x893/CMSIS-DAP/README.md

CMSIS-DAP Version 0.01
----------------------

See Readme.htm for details
