x893/CMSIS-DAP/html/CMSIS_DAP_INTERFACE.png

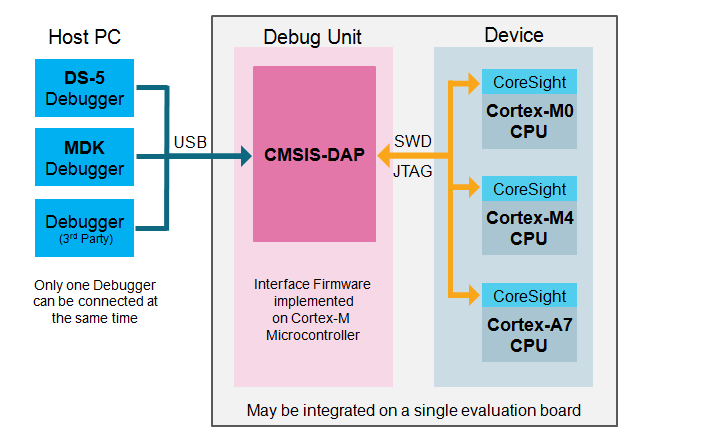
html/CMSIS_DAP_INTERFACE.png
