x893/CMSIS-DAP/html/MDK_Device.png

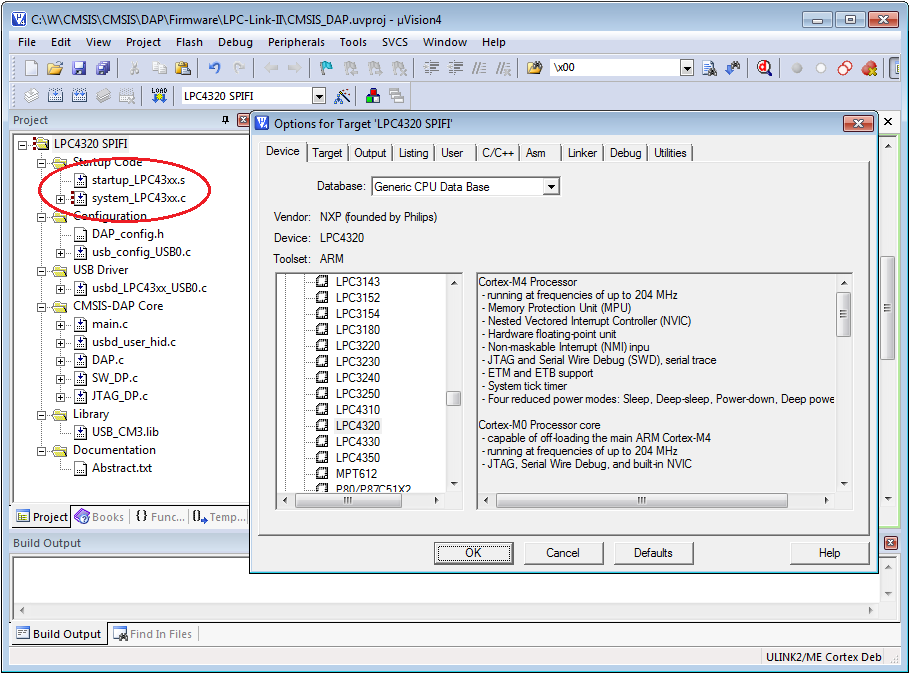
html/MDK_Device.png
