x893/CMSIS-DAP/html/MDK_USB.png

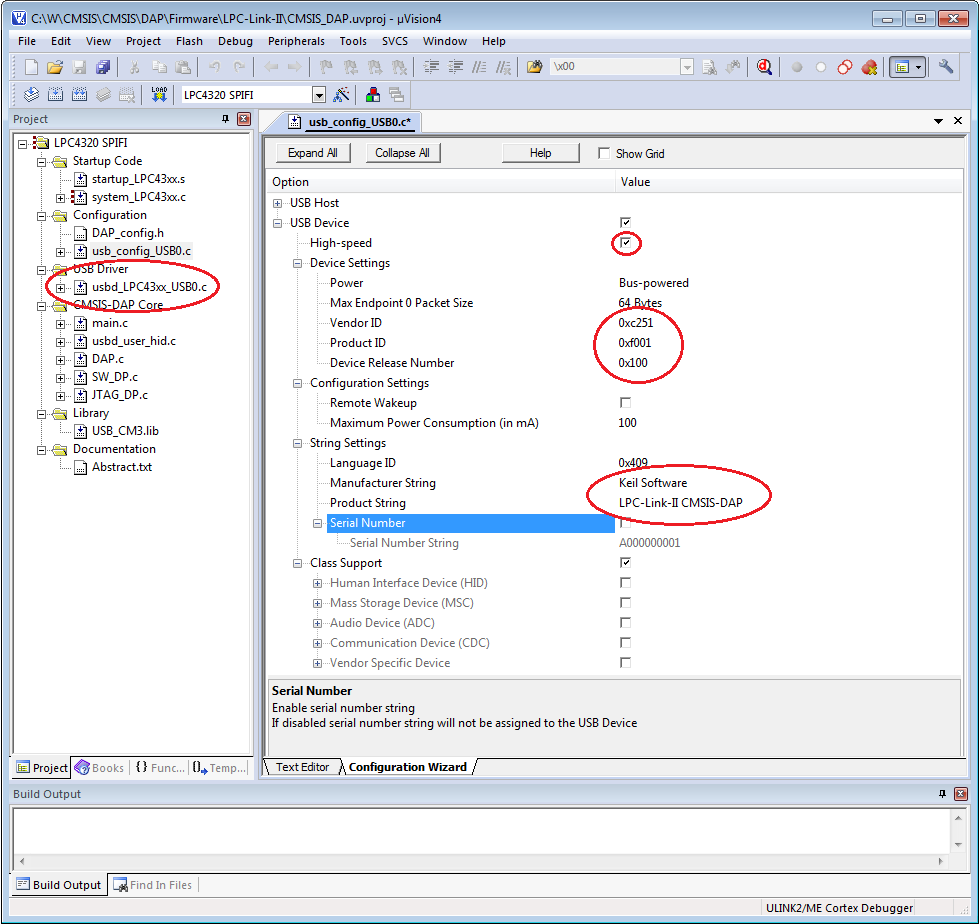
html/MDK_USB.png
