x893/CMSIS-DAP/HW_STM32/CMSIS-DAP-Other/10pin.png

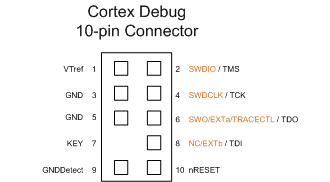
HW_STM32/CMSIS-DAP-Other/10pin.png
