x893/CMSIS-DAP/HW_STM32/CMSIS-DAP-Other/STM32-P103-sch.gif

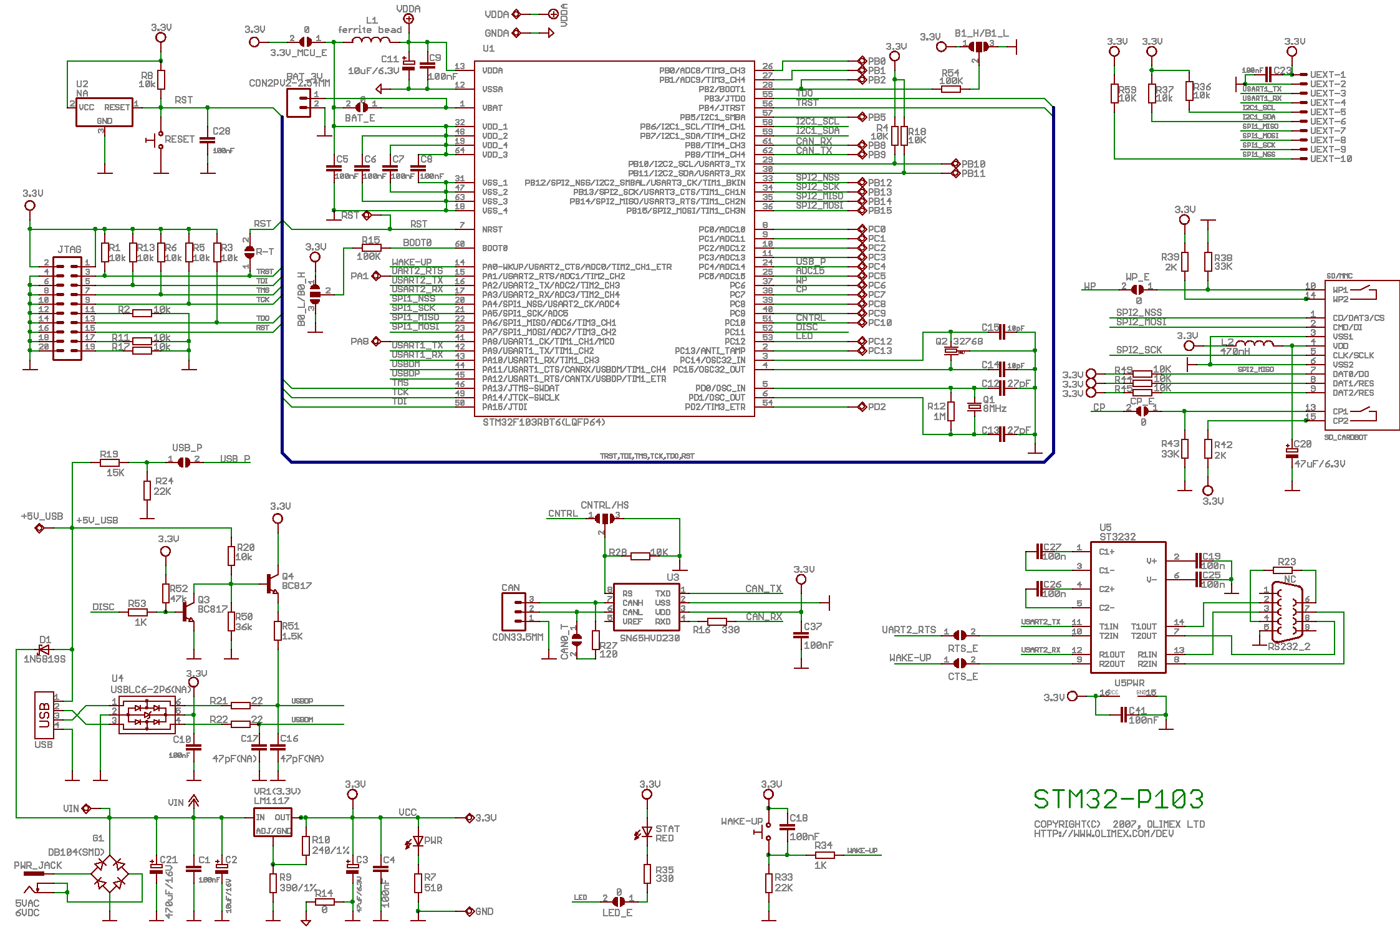
HW_STM32/CMSIS-DAP-Other/STM32-P103-sch.gif
