x893/CMSIS-DAP/HW_STM32/JLink-OB-F072.png

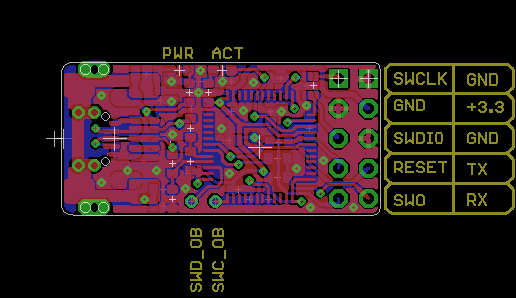
HW_STM32/JLink-OB-F072.png
