x893/CMSIS-DAP/HW_STM32/CMSIS-DAP-Other/CMSIS_DAP.ods

 | CMSIS_DAP.sch
RefDes | Value | Count
--------------- | --------------- | ------
C13 | SMD-0805-X7R-0.01uF-50V | 1
C2 | SMD-0805-X7R-0.1uF-50V | 7
C3
C5
C6
C7
C8
C14
C9 | SMD-0805-NP0-12pF | 2
C10
C11 | SMD-0805-NP0-18pF | 2
C12
C1 | SMD3216-10uF-16V-A | 2
C4
DD1 | STM32F103C8T6 | 1
DA1 | LP2985AIM5-3.0 (LP2981-3.0) | 1
R5 | SMD-0603-1k | 2
R13
R24 | SMD-0603-1M | 1
R1 | SMD-0603-1.5k | 1
R14 | SMD-0603-2.2k | 1
R11 | SMD-0603-2.2M | 1
R9 | SMD-0603-3.3 | 1
R2 | SMD-0603-10k | 5
R15
R16
R19
R23
R22 | SMD-0603-22 | 1
R7 | SMD-0603-22k | 2
R20
R3 | SMD-0603-36k | 1
R4 | SMD-0603-47k | 1
R17 | SMD-0805-1k | 2
R18
R12 | SMD-0805-10 | 1
R6 | SMD-0805-5k | 1
R21 | SMD-0805-22 | 1
R8 | SMD-1206-22 | 2
R10
VD2 | FYLS-0805 (GREEN) | 1
VD1 | FYLS-0805 (RED) | 1
VT1 | BC817 | 2
VT2
XP5 | BH-10 | 1
XP2 | PLS-2 | 3
XP3
XP4
XP1 | PLS-4 | 2
XP6
XS1 | USB_B | 1
ZQ1 | KX38T-32768Hz | 1
ZQ2 | HC49/u-8.000MHz | 1
