x893/CMSIS-DAP/(threads)

Thread 4 (2015-05-25):

Can't install HID driver for F103 v2

steevenlee, 2015-05-25:
I'm using MDK5 + CMSIS_DAP_USB project, set reconfiguration to V2, both HID and CDC are enabled, from test, only CDC are properly installed on Windows7 32 bit version. HID can't be recognized.

If I disable CDC in usb_config.c, HID can be auto recognized w/o installing any driver.

Finally I got it worked by changing VID/PID to official one and install driver from mbed, it will identify HID driver, then, install inf for CDC ACM.

x893, 2015-05-28:
For HID no need any driver under Windows 7. I use 64 bit version and never have problem.

steevenlee, 2015-05-29:
Try it on a new desktop :)

Closed 2015-05-28.

Thread 5 (2015-05-28):

How about merge back this project back to master?

steevenlee, 2015-05-28:
I love your work, STM32 is popular... is there license issue if I give this a try?

x893, 2015-05-28:
CMSIS-DAP codes initially provide by ARM

steevenlee, 2015-06-01:
I found a big issue to merge SMT32 support to official branch: stm32f10x only support 8 endpoints, for a complete feature support, need 3+2+2 for CDC+MSC+HID, plus endpoint 0, is it possible to support them all?

x893, 2015-06-01:
i never use this combination only HID + CDC but you can try

Closed 2015-05-28.

Thread 6 (2015-09-07):

Can't find MSD on my computer.

overheat, 2015-09-07:
I have flashed the hex file to my st-link. And my computer recognized CDC(uart) and debugger.
But there is no MSD showing like other mbed board.

Please help me. Thanks!

x893, 2015-09-07:
MSD not supported

Closed 2015-09-07.

Thread 8 (2016-01-14):

ST-LinkV2 nRESET pin

siorpaes, 2016-01-14:
Hello,

I tried CMSIS-DAP on ST-LinkV2 dongle using Keil but found some issues with nRESET signal: the target could not reset nor I could use the "attach under reset" debugger option. The logic analyzer could not see any activity on this signal either.
I checked where the nRESET pin is connected on this board and sorted out that it is hooked to PB6 (Pin 42), and not PB0 as reported in the code.

I changed to correct pin and now it's working like a charm. Is the dongle I have yet a different hardware version ? Or is there actually a minor bug in the code ?

Thanks for your attention

Regards,

David S.

x893, 2016-01-14:
Hello,
I have various version of dongle - so may be make a mistake.
I'll review and fix

siorpaes, 2016-01-14:
All right, thanks! let me know if you need any further information, esp on the dongle's hardware

x893, 2016-01-16:
I check ST-Link V2 schematic (from NUCLEO board) and see PB0 for T_NRST signal. PB6 used for SWM_RST (for SWIM protocol)

siorpaes, 2016-01-17:
Yes, you are correct: the schematic of Nucleo and Discovery boards do have NRST routed to PB0. However, the RST signal of the ST-LinkV2 dongle I have is connected to PB6. I triple checked continuity with multimeter. Could you verify on yours ?

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

x893, 2016-01-17:
I havn't V2 version but you can make new configuration STLINKV2 and make changes for nRST. Later send pull request. I can do this myself but later. :)

Closed 2016-01-14.

Thread 10 (2016-10-04):

Did not find most variables declared in RDDI example

umesh4b4, 2016-10-04:
Hi,

I did not find most number of variables declared in RDDI example RDDI_DAP_IF.cpp file  given in CMSIS-DAP-> RDDI->Example. However I have solved with few variables and macros. I could not find below variables, macros and data types.

1. MonConf.Opt
2. PORT_SW
3. RWPage
4. TRNMODE
5. TRNVERIFY
6. DBG_Addr
7. RgARMCM
8. RgARMFPU

Regards

Umesh

x893, 2016-10-04:
Ask about on ARM forum. RDDI... not changed from original ARM files.

Closed 2016-10-04.

Thread 11 (2017-08-16):

USB devices are not recognized

HareGun, 2017-08-16:
I want to make a CMSIS DAP using CMSIS 5.1.0. I built a new project in line with KEIL's official website. Part of the DAP was added, but he didn't work. Can you help me with this problem? Thanks very much.

http://www.keil.com/pack/doc/CMSIS/DAP/html/group__DAP__ConfigUSB__gr.html

bowman85, 2017-08-17:
I can recomended to use this lib.  https://stm32f4-discovery.net/2014/05/all-stm32f429-libraries-at-one-place/

HareGun, 2017-08-17:
Thanks.But I'm using STM32F1. I've also tried to configure only the USB and RTX sections without DAP (adding the USB connection function to the main function). My computer is still hard to recognize. The D+ pin has a pull-up resistor.

Closed 2018-01-11.

Thread 12 (2018-01-11):

When compiled HID device is not recognised by the system.

diymat, 2018-01-11:
Hi. Just a quick question-maybe you know. When I flash the stm32F103 with the .hex file provided - everything is ok, when I compile it myself only CDC device is recognised. Do you have any clues?

x893, 2018-01-11:
You're change any settings (optimization or other) ?
Can you check with debugger ?

diymat, 2018-01-11:
No, I have just cloned it and opened in the free version of Keil (I do not use Keil). I can debug of course

x893, 2018-01-11:
Project from github use F102 processor settings. May be need switch to correct version V1..V3 and F103 processor. Please check project settings for your board.

diymat, 2018-01-11:
I have changed the uC of course.  But where is the version?

diymat, 2018-01-11:
Recompiled - checked all the uC settings and the effect is the same -  VCOM is detected, HID is not. When I flash the provided HEX file it detects both :)

x893, 2018-01-11:
What's hex you flash ?

CMSIS-DAP-V1-F103.hex
CMSIS-DAP-V2-F103.hex
CMSIS-DAP-V3-F103.hex

diymat, 2018-01-11:
just flashed all of them. All provide both devices. The compiled version is not and to be stranger it detects as a different COM port which indicates some differences between descriptors sent.

x893, 2018-01-11:
Select configuration in tollbar combo box (near Download toolbar button).
Also check pins in DAP_Config.h for your board.

diymat, 2018-01-11:
As I wrote I do not know Keil :) and I did not noticed this toolbar. But unfortunately free version does not allow me to link the MDK

diymat, 2018-01-11:
Thank you very much for your support.

x893, 2018-01-11:
Can you check DAP_Config.h for your board ?
You can open it in vim/nano/notepad and define configuration.
Also you can flash hex files and see correct hex for your board (USB and SWD/SWC/JTAG pins configuration) or add schematic of your board here and i see in depth.

diymat, 2018-01-11:
Hi. Thank you very much. Actually I  have everything I need.  I develop a board with DAP - so I just wanted to go through the existing implementation to do not reinvent the wheel. It is a STM32F3 board with many other interfaces on it. I honestly appreciate your help.

x893, 2018-01-11:
No problem.

Closed 2018-01-11.

Thread 14 (2018-04-07):

"CMSIS-DAP CDC" driver installation problem

alsaleem00, 2018-04-07:
I am developing a code for RTL8710 Wifi module, cortex-M3. The toolchain/sdk requires OpenOCD/CMSIS-DAP to program the module.
I have a STM32F103C8T6 board that I would like to make as CMSIS-DAP. I tried all firmware images in the firmware/stm32/hex, but still there is error when trying to update driver on windows 8.1

> The drivers for this device are not installed. (Code 28)
> There are no compatible drivers for this device.

I already configured windows to "ignore" driver signing and restarted several times.
I point update driver update to folder that contains the "CMSIS_DAP.inf" file.

OpenOCD returns the following error

> Error: CMSIS-DAP command CMD_INFO failed

Did I miss a step to install driver?

Thanks.

Thread 15 (2018-09-20):

STM32 Blue Pill - using V1.hex

kissste, 2018-09-20:
Hello,

I have uploaded V1.hex to SMT32 Blue Pill board (patched R10 resistor to get USB going).

I see CDC and HID devices but on Linux (Ubuntu 18.04) but there is not mass-storage device (mbedls is looking for it). I'm trying to get this working with mbed (to start with mbedls).

The target is connected via PA2 and PA4 as noted in build/ code of BOARD_V1.
I have not solder/ checked the LEDs yet. And, think I will hook up a scope to see what is being sent on SWCLK and SWDIO wires.

Any suggestions for what could be the issue, how to debug?

Thank you very much
