x893/CMSIS-DAP/HW_STM32/CMSIS-DAP-X893/STLink.v21.pdf

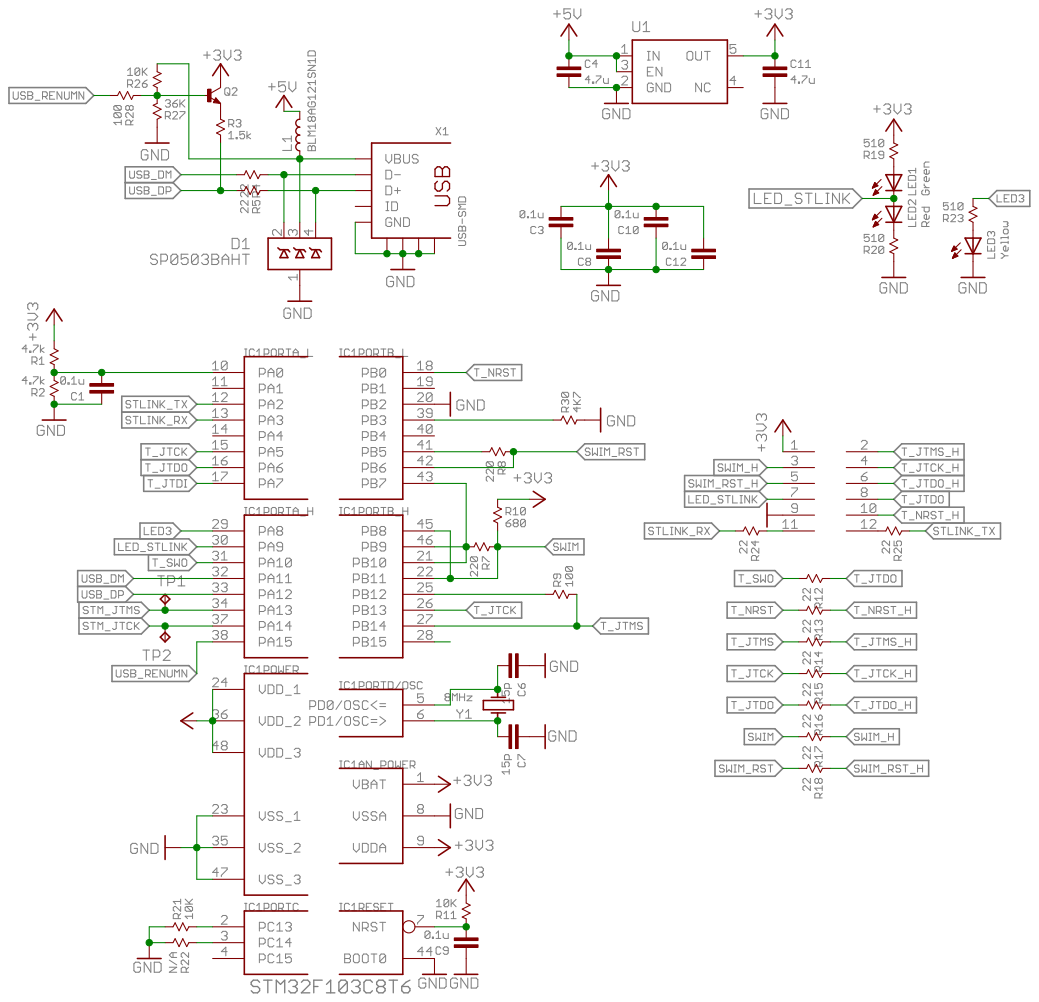
[picture p7: page 1]
