x893/CMSIS-DAP/HW_STM32/CMSIS-DAP-X893/CMSIS-DAP.V2.pdf

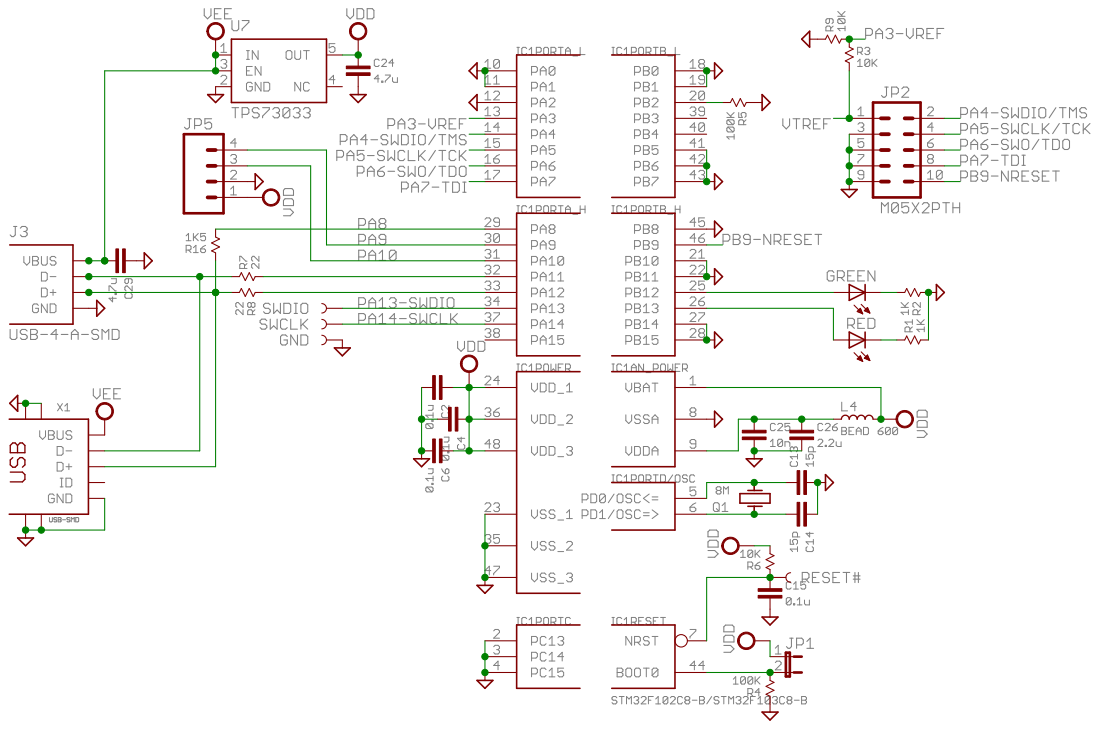
[picture p8: page 1]
