x893/CMSIS-DAP/HW_STM32/CMSIS-DAP-X893/CMSIS-DAP.V1.pdf

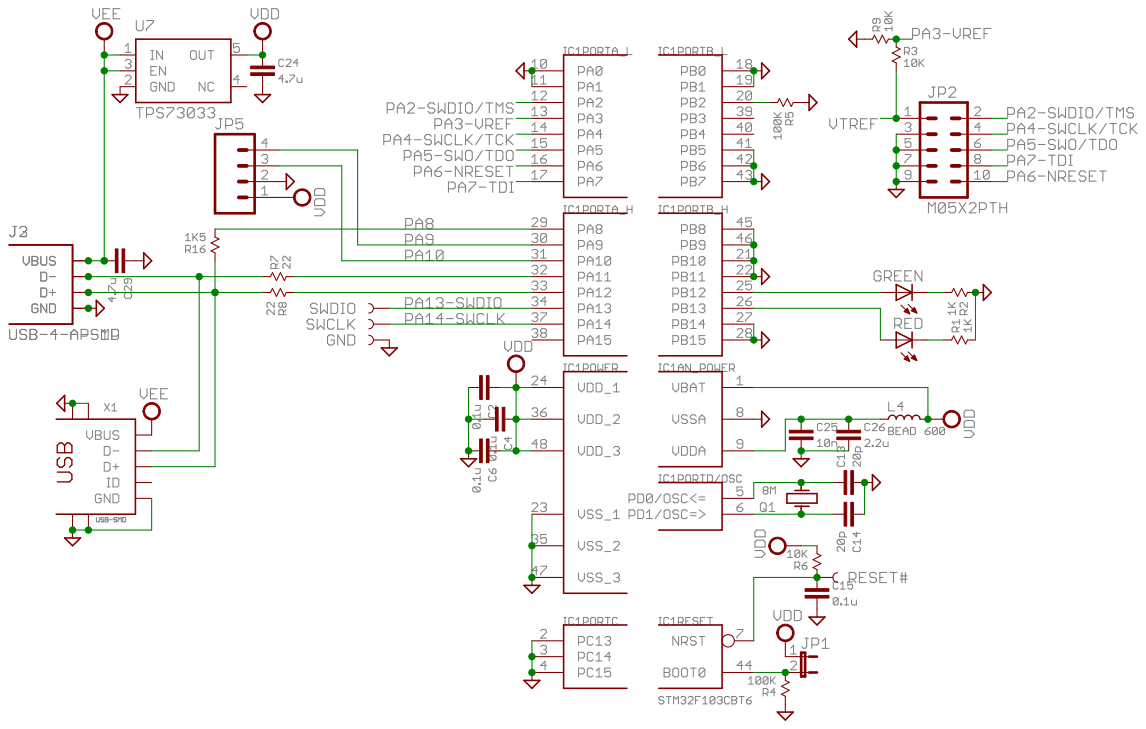
[picture p9: page 1]
