x893/CMSIS-DAP/(list of files, drawings)

Other design files:
HW_STM32/CMSIS-DAP-Other/CMSIS_DAP.pcb
