x893/CMSIS-DAP/HW_STM32/JLink-OB-F072.brd

## EAGLE design HW_STM32/JLink-OB-F072.brd (2016-11-28)

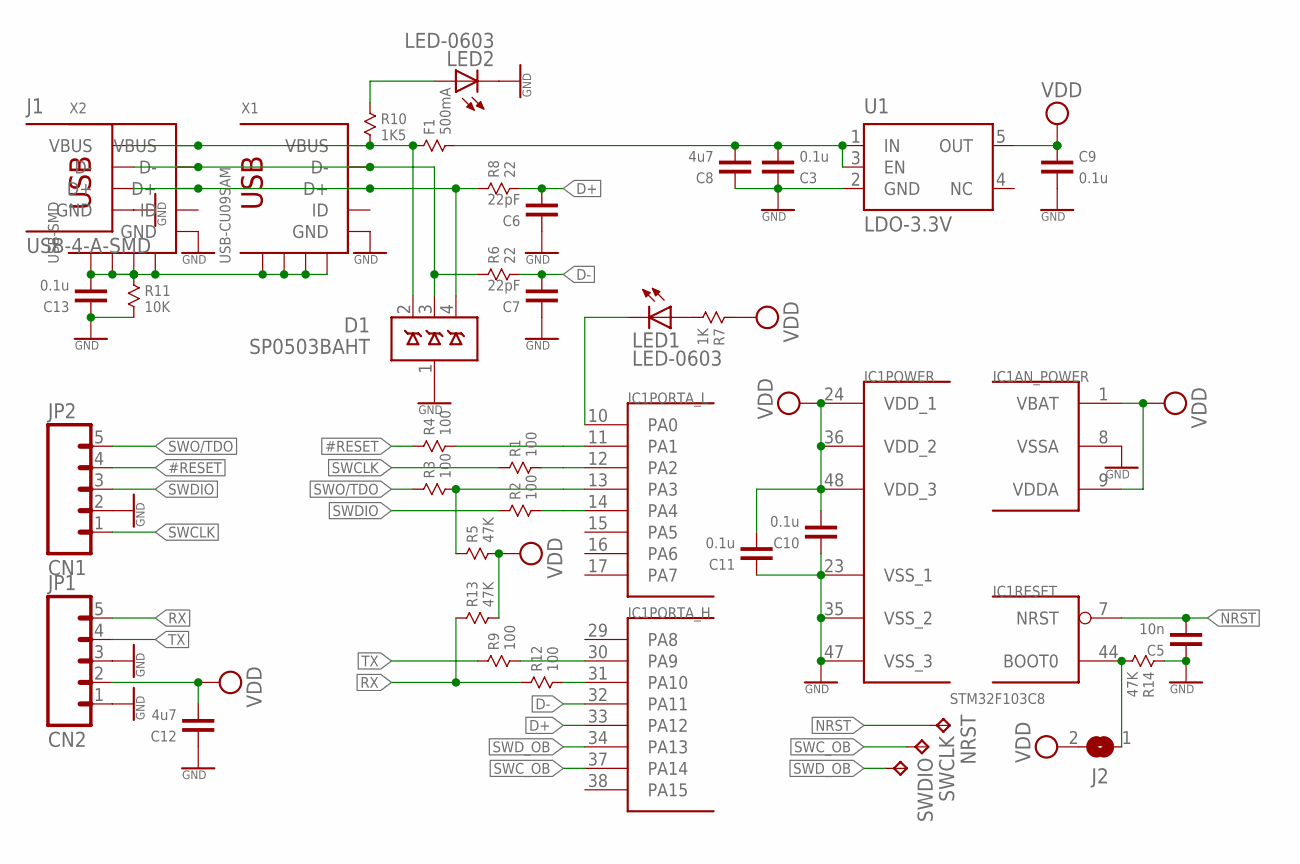
[picture p10: schematic JLink-OB-F072.sch]

Parts:
C3, C9, C10, C11, C13: 0.1u; 0603
C5: 10n; 0603
C6, C7: 22pF; 0603
C8, C12: 4u7; 0603
D1: SP0503BAHT; SOT143
F1: 500mA; 0805
IC1: STM32F103C8; TQFP48
J1: USB-4-A-SMD; USB-A-SMD
J2: JUMPER2-0402-NC; JUMPER2-0402_NC
JP1: CN2; 1X05
JP2: CN1; 1X05
LED1, LED2: LED-0603; CHIPLED_0603
NRST: TPTP10R; TP10R
R1, R2, R3, R4, R9, R12: 100; 0603
R5, R13, R14: 47K; 0603
R6, R8: 22; 0603
R7: 1K; 0603
R10: 1K5; 0603
R11: 10K; 0603
SWCLK: TPTP10R; TP10R
SWDIO: TPTP10R; TP10R
U1: LDO-3.3V; SOT23-5
X1: USB-CU09SAM; CU09SAM
X2: USB-SMD; USB-MINIB

Connections:
#RESET: JP2.4, R4.1
#RESETR: IC1.11 (PA1), R4.2
D+: C6.1, IC1.33 (PA12), R8.2
D-: C7.1, IC1.32 (PA11), R6.2
GND: C3.2, C5.2, C6.2, C7.2, C8.2, C9.1, C10.2, C11.2, C12.2, C13.2, D1.1 (GND), IC1.8 (VSSA), IC1.23 (VSS_1), IC1.35 (VSS_2), IC1.47 (VSS_3), J1.GND, JP1.1, JP1.3, JP2.2, LED2.C, R11.2, R14.1, U1.2 (GND), X1.5 (GND), X2.GND
unnamed: LED1.A, R7.2
unnamed: D1.4 (D3), J1.D+, R8.1, X1.3 (D+), X2.D+
unnamed: IC1.10 (PA0), LED1.C
unnamed: D1.3 (D2), J1.D-, R6.1, X1.2 (D-), X2.D-
unnamed: IC1.30 (PA9), R9.2
unnamed: IC1.31 (PA10), R12.2
unnamed: LED2.A, R10.1
unnamed: C3.1, C8.1, F1.2, U1.1 (IN), U1.3 (EN)
unnamed: IC1.44 (BOOT0), J2.1, R14.2
unnamed: C13.1, R11.1, X1.GND@1 (GND), X1.GND@2 (GND), X1.GND@3 (GND), X1.GND@4 (GND), X2.GND@1 (GND), X2.GND@2 (GND), X2.GND@3 (GND), X2.GND@4 (GND)
NRST: C5.1, IC1.7 (NRST), NRST.TP
RX: JP1.5, R12.1, R13.1
SWCLK: JP2.1, R1.1
SWCLKR: IC1.12 (PA2), R1.2
SWC_OB: IC1.37 (PA14), SWCLK.TP
SWDIO: JP2.3, R2.1
SWDIOR: IC1.14 (PA4), R2.2
SWD_OB: IC1.34 (PA13), SWDIO.TP
SWO/TDO: JP2.5, R3.1
SWOR: IC1.13 (PA3), R3.2, R5.1
TX: JP1.4, R9.1
VBUS: D1.2 (D1), F1.1, J1.VUSB (VBUS), R10.2, X1.1 (VBUS), X2.VBUS
VDD: C9.2, C10.1, C11.1, C12.1, IC1.1 (VBAT), IC1.9 (VDDA), IC1.24 (VDD_1), IC1.36 (VDD_2), IC1.48 (VDD_3), J2.2, JP1.2, R5.2, R7.1, R13.2, U1.5 (OUT)

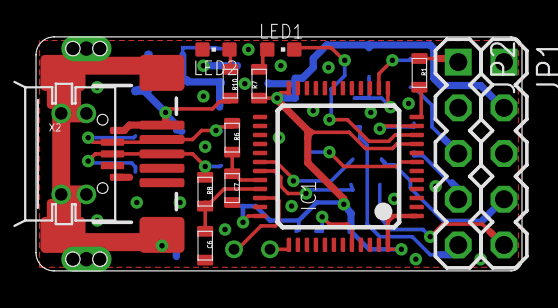
[picture p11: board JLink-OB-F072.brd from above]

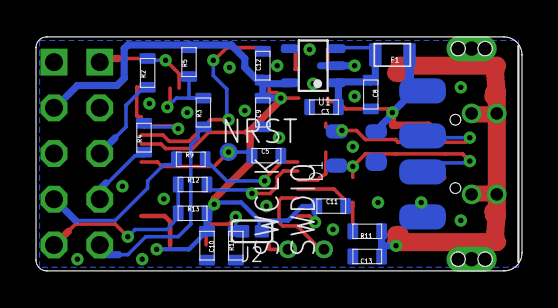
[picture p12: board JLink-OB-F072.brd from below]

Board: 2 copper layers, 27.0 x 13.0 mm, 39 parts (25 on the bottom side), 28 nets.
