x893/CMSIS-DAP/HW_STM32/JLink-OB.brd

## EAGLE design HW_STM32/JLink-OB.brd (2016-01-17)

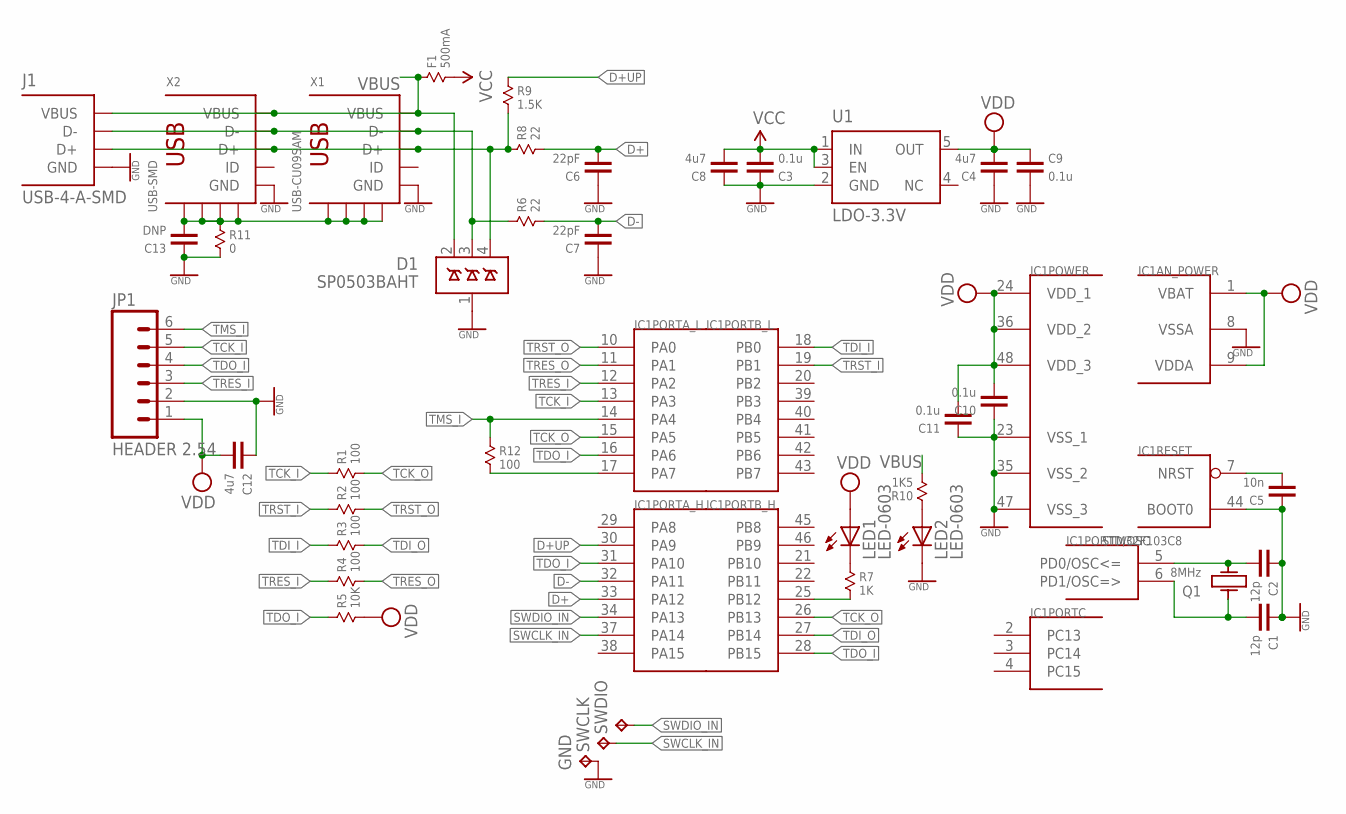
[picture p13: schematic JLink-OB.sch]

Parts:
C1, C2: 12p; 0603
C3, C9, C10, C11: 0.1u; 0603
C4, C8, C12: 4u7; 0603
C5: 10n; 0603
C6, C7: 22pF; 0603
C13: DNP; 0603
D1: SP0503BAHT; SOT143
F1: 500mA; 0805
GND: TPTP12R; TP12R
IC1: STM32F103C8; TQFP48
J1: USB-4-A-SMD; USB-A-SMD
JP1: HEADER 2.54; 1X06
LED1, LED2: LED-0603; CHIPLED_0603
Q1: 8MHz; KX-9A
R1, R2, R3, R4, R12: 100; 0603
R5: 10K; 0603
R6, R8: 22; 0603
R7: 1K; 0603
R9: 1.5K; 0603
R10: 1K5; 0603
R11: 0; 0603
SWCLK: TPTP12R; TP12R
SWDIO: TPTP12R; TP12R
U1: LDO-3.3V; SOT23-5
X1: USB-CU09SAM; CU09SAM
X2: USB-SMD; USB-MINIB

Connections:
D+: C6.1, IC1.33 (PA12), R8.2
D+UP: IC1.30 (PA9), R9.1
D-: C7.1, IC1.32 (PA11), R6.2
GND: C1.2, C2.2, C3.2, C4.2, C5.2, C6.2, C7.2, C8.2, C9.1, C10.2, C11.2, C12.2, C13.2, D1.1 (GND), GND.TP, IC1.8 (VSSA), IC1.23 (VSS_1), IC1.35 (VSS_2), IC1.44 (BOOT0), IC1.47 (VSS_3), J1.GND, JP1.2, LED2.C, R11.2, U1.2 (GND), X1.5 (GND), X2.GND
unnamed: C5.1, IC1.7 (NRST)
unnamed: D1.4 (D3), J1.D+, R8.1, R9.2, X1.3 (D+), X2.D+
unnamed: IC1.25 (PB12), R7.2
unnamed: D1.3 (D2), J1.D-, R6.1, X1.2 (D-), X2.D-
unnamed: C2.1, IC1.5 (PD0/OSC<=), Q1.3 (2)
unnamed: C1.1, IC1.6 (PD1/OSC=>), Q1.1
unnamed: LED2.A, R10.1
unnamed: LED1.C, R7.1
unnamed: C13.1, R11.1, X1.GND@1 (GND), X1.GND@2 (GND), X1.GND@3 (GND), X1.GND@4 (GND), X2.GND@1 (GND), X2.GND@2 (GND), X2.GND@3 (GND), X2.GND@4 (GND)
SWCLK_IN: IC1.37 (PA14), SWCLK.TP
SWDIO_IN: IC1.34 (PA13), SWDIO.TP
TCK_I: IC1.13 (PA3), JP1.5, R1.1
TCK_O: IC1.15 (PA5), IC1.26 (PB13), R1.2
TDI_I: IC1.18 (PB0), R3.1
TDI_O: IC1.27 (PB14), R3.2
TDO_I: IC1.16 (PA6), IC1.28 (PB15), IC1.31 (PA10), JP1.4, R5.1
TMS_I: IC1.14 (PA4), JP1.6, R12.1
TMS_O: IC1.17 (PA7), R12.2
TRES_I: IC1.12 (PA2), JP1.3, R4.1
TRES_O: IC1.11 (PA1), R4.2
TRST_I: IC1.19 (PB1), R2.1
TRST_O: IC1.10 (PA0), R2.2
VBUS: D1.2 (D1), F1.1, J1.VUSB (VBUS), R10.2, X1.1 (VBUS), X2.VBUS
VCC: C3.1, C8.1, F1.2, U1.1 (IN), U1.3 (EN)
VDD: C4.1, C9.2, C10.1, C11.1, C12.1, IC1.1 (VBAT), IC1.9 (VDDA), IC1.24 (VDD_1), IC1.36 (VDD_2), IC1.48 (VDD_3), JP1.1, LED1.A, R5.2, U1.5 (OUT)

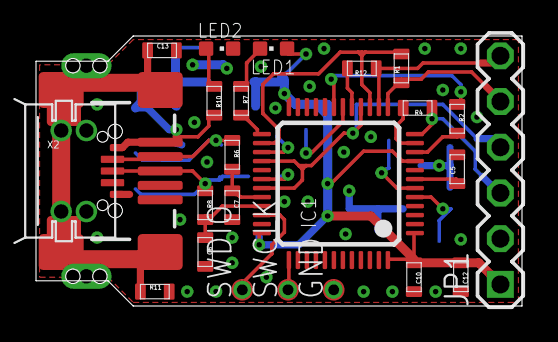
[picture p14: board JLink-OB.brd from above]

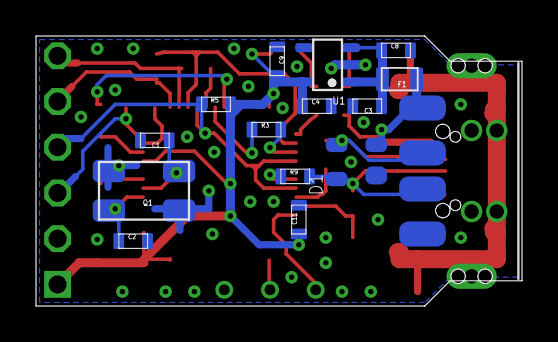
[picture p15: board JLink-OB.brd from below]

Board: 2 copper layers, 27.0 x 15.0 mm, 39 parts (15 on the bottom side), 29 nets.
