x893/CMSIS-DAP/HW_STM32/CMSIS-DAP-X893/STLink.v21.brd

## EAGLE design HW_STM32/CMSIS-DAP-X893/STLink.v21.brd (2015-07-23)

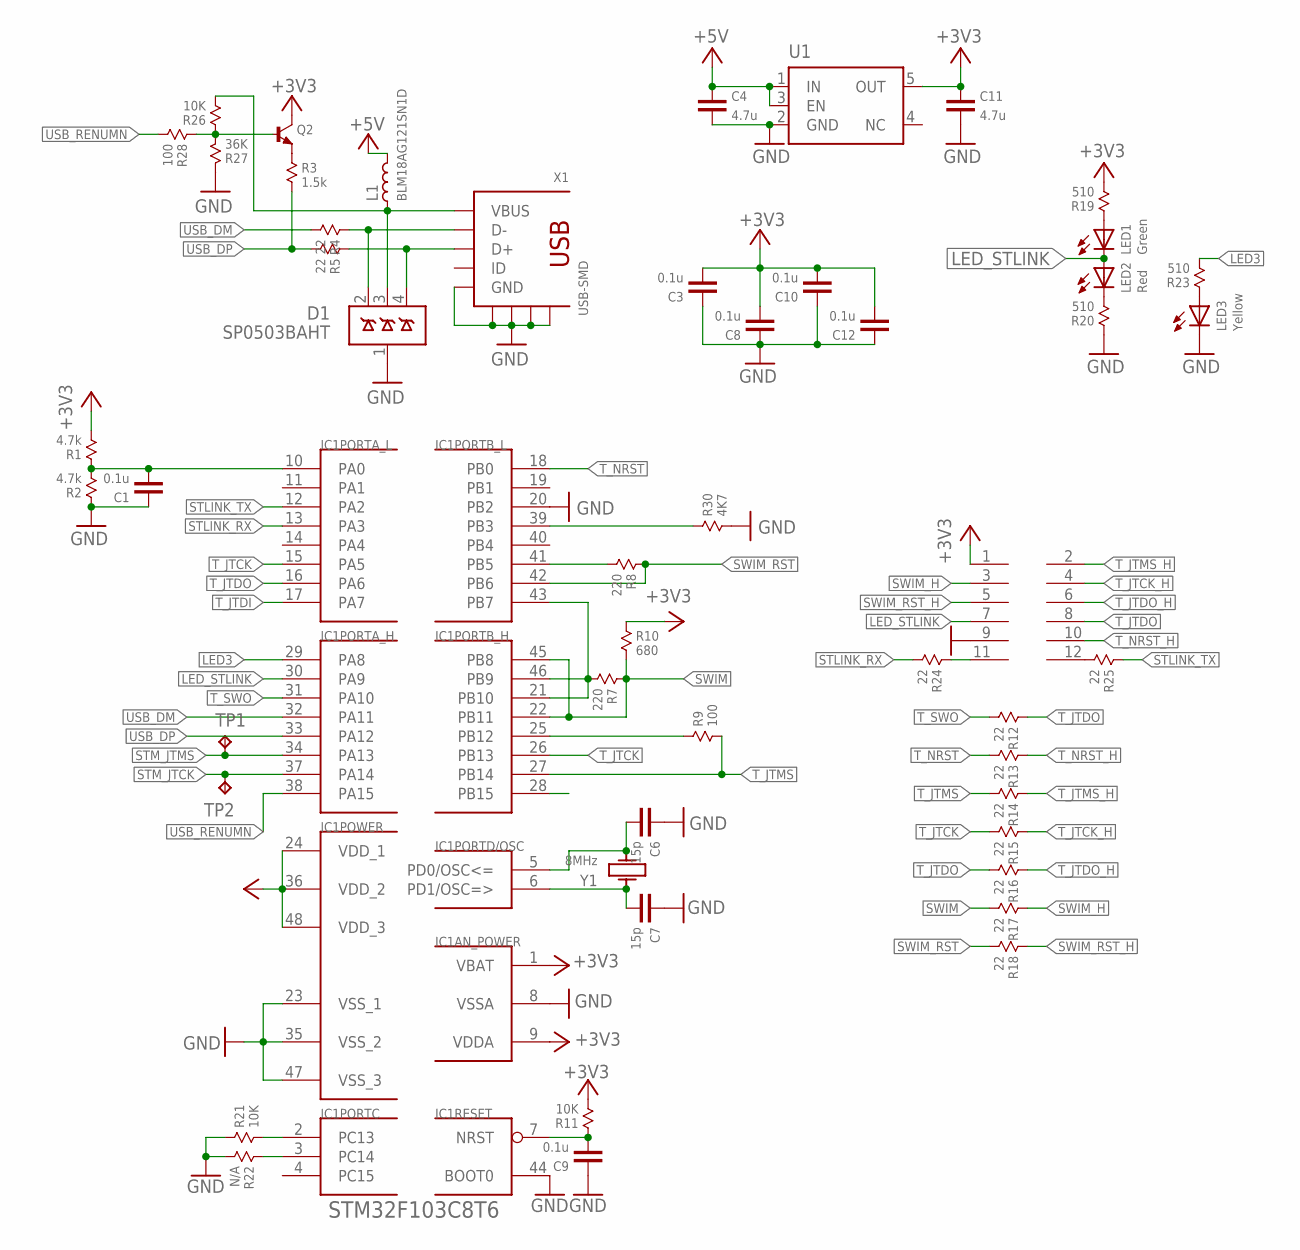
[picture p16: schematic STLink.v21.sch]

Parts:
C1, C3, C8, C9, C10, C12: 0.1u; 0603
C4, C11: 4.7u; 0603
C6, C7: 15p; 0603
CN2: M06X2; PLANAR-6X2
D1: SP0503BAHT; SOT143
IC1: STM32F103C8T6; TQFP48
L1: BLM18AG121SN1D; 0603
LED1: Green; CHIP-LED0603
LED2: Red; CHIP-LED0603
LED3: Yellow; CHIP-LED0603
Q2: NPNBC847; SOT-23
R1, R2: 4.7k; 0603
R3: 1.5k; 0603
R4, R5, R12, R13, R14, R15, R16, R17, R18, R24, R25: 22; 0603
R7, R8: 220; 0603
R9, R28: 100; 0603
R10: 680; 0603
R11, R21, R26: 10K; 0603
R19, R20, R23: 510; 0603
R22: N/A; 0603
R27: 36K; 0603
R30: 4K7; 0603
TP1, TP2: TPTP10R; TP10R
U1: TPS73033; SOT23-5
X1: USB-SMD; USB-MINIB
Y1: 8MHz; C0532

Connections:
+3V3: C3.1, C8.1, C10.1, C11.2, C12.1, CN2.1, IC1.1 (VBAT), IC1.9 (VDDA), IC1.24 (VDD_1), IC1.36 (VDD_2), IC1.48 (VDD_3), Q2.3 (C), R1.2, R10.1, R11.2, R19.2, U1.5 (OUT)
+5V: C4.2, L1.2, U1.1 (IN), U1.3 (EN)
AIN1: C1.1, IC1.10 (PA0), R1.1, R2.2
GND: C1.2, C3.2, C4.1, C6.2, C7.2, C8.2, C9.2, C10.2, C11.1, C12.2, CN2.9, D1.1 (GND), IC1.8 (VSSA), IC1.20 (PB2), IC1.23 (VSS_1), IC1.35 (VSS_2), IC1.44 (BOOT0), IC1.47 (VSS_3), LED3.C, R2.1, R20.1, R21.1, R22.2, R27.1, R30.2, U1.2 (GND), X1.GND, X1.GND@1 (GND), X1.GND@2 (GND), X1.GND@3 (GND), X1.GND@4 (GND)
LED3: IC1.29 (PA8), R23.2
LED_STLINK: CN2.7, IC1.30 (PA9), LED1.C, LED2.A
unnamed: C6.1, IC1.5 (PD0/OSC<=), Y1.3 (2)
unnamed: C7.1, IC1.6 (PD1/OSC=>), Y1.1
unnamed: C9.1, IC1.7 (NRST), R11.1
unnamed: IC1.39 (PB3), R30.1
unnamed: D1.2 (D1), R4.1, X1.D-
unnamed: D1.4 (D3), R5.1, X1.D+
unnamed: LED2.C, R20.2
unnamed: LED1.A, R19.1
unnamed: D1.3 (D2), L1.1, R26.2, X1.VBUS
unnamed: CN2.11, R24.1
unnamed: CN2.12, R25.2
unnamed: LED3.A, R23.1
unnamed: Q2.2 (E), R3.1
unnamed: IC1.2 (PC13), R21.2
unnamed: IC1.3 (PC14), R22.1
unnamed: Q2.1 (B), R26.1, R27.2, R28.1
STLINK_RX: IC1.13 (PA3), R24.2
STLINK_TX: IC1.12 (PA2), R25.1
STM_JTCK: IC1.37 (PA14), TP2.TP
STM_JTMS: IC1.34 (PA13), TP1.TP
SWIM: IC1.22 (PB11), IC1.45 (PB8), R7.1, R10.2, R17.2
SWIM_H: CN2.3, R17.1
SWIM_IN: IC1.21 (PB10), IC1.43 (PB7), IC1.46 (PB9), R7.2
SWIM_RST: IC1.42 (PB6), R8.1, R18.2
SWIM_RST_H: CN2.5, R18.1
SWIM_RST_IN: IC1.41 (PB5), R8.2
T_JTCK: IC1.15 (PA5), IC1.26 (PB13), R15.2
T_JTCK_H: CN2.4, R15.1
T_JTDI: IC1.17 (PA7)
T_JTDO: CN2.8, IC1.16 (PA6), R12.1, R16.2
T_JTDO_H: CN2.6, R16.1
T_JTMS: IC1.27 (PB14), R9.2, R14.2
T_JTMS_H: CN2.2, R14.1
T_NRST: IC1.18 (PB0), R13.2
T_NRST_H: CN2.10, R13.1
T_SWDIO_IN: IC1.25 (PB12), R9.1
T_SWO: IC1.31 (PA10), R12.2
USB_DM: IC1.32 (PA11), R4.2
USB_DP: IC1.33 (PA12), R3.2, R5.2
USB_RENUMN: IC1.38 (PA15), R28.2

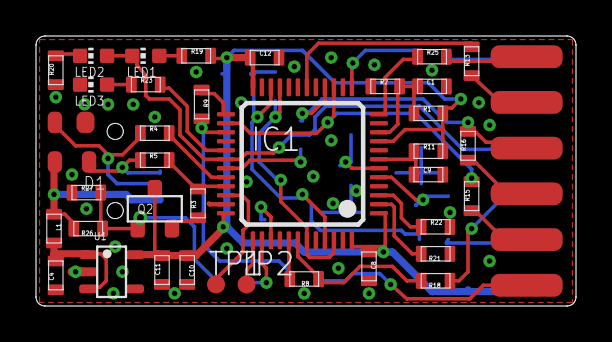
[picture p17: board STLink.v21.brd from above]

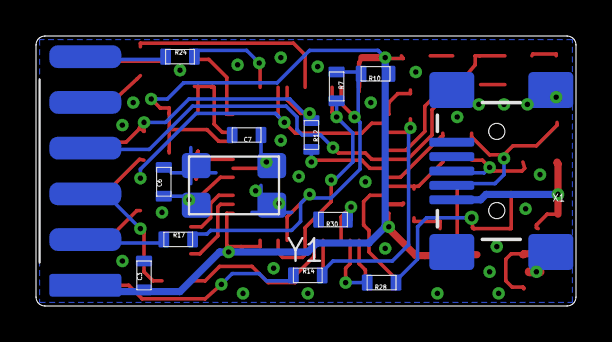
[picture p18: board STLink.v21.brd from below]

Board: 2 copper layers, 30.0 x 15.0 mm, 51 parts (14 on the bottom side), 45 nets.
