x893/CMSIS-DAP/HW_STM32/CMSIS-DAP-X893/CMSIS-DAP.V2.brd

## EAGLE design HW_STM32/CMSIS-DAP-X893/CMSIS-DAP.V2.brd (2014-11-15)

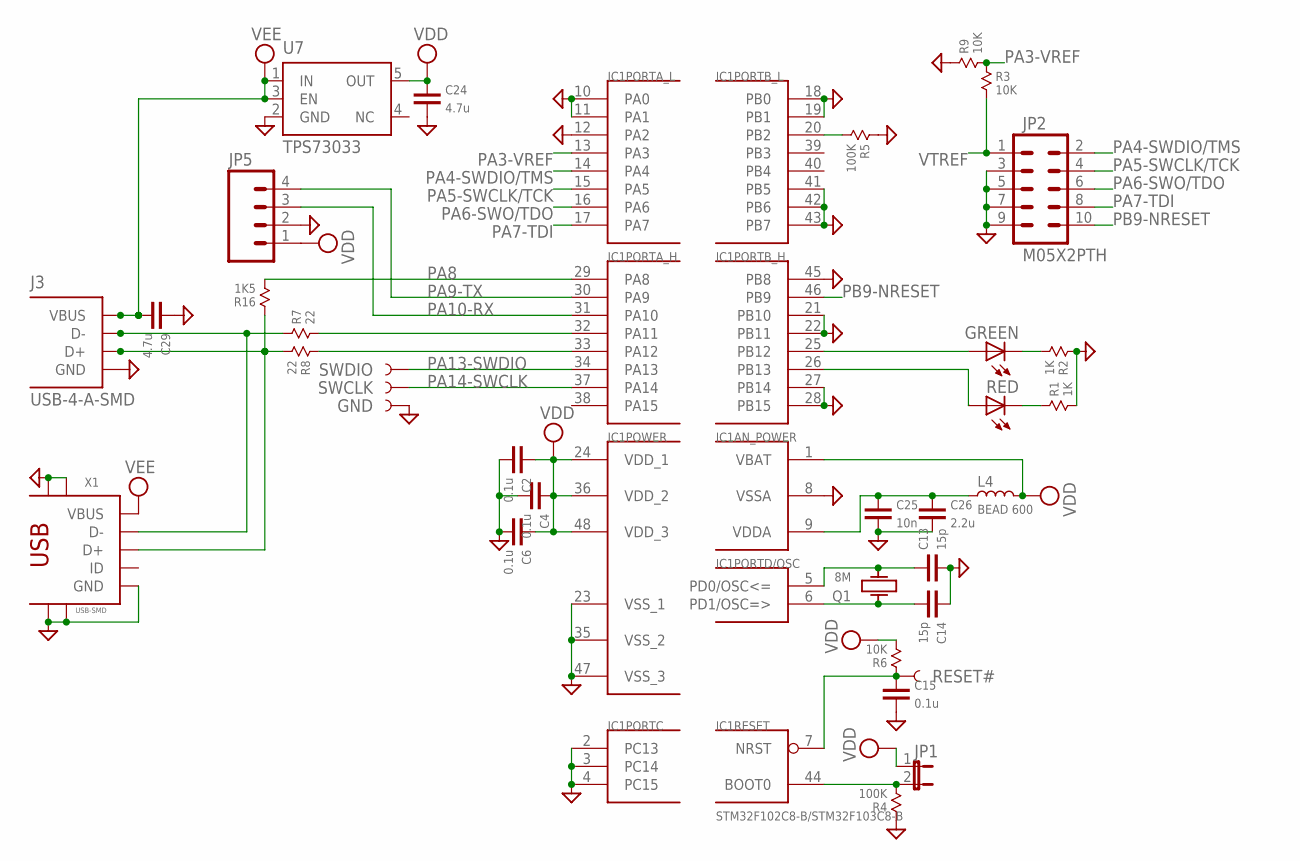
[picture p19: schematic CMSIS-DAP.V2.sch]

Parts:
C2, C4, C6, C15: 0.1u; 0603
C13, C14: 15p; 0603
C24, C29: 4.7u; 0603
C25: 10n; 0603
C26: 2.2u; 0603
GND: TEST-POINT1; PAD.1X1
GREEN: LEDCHIPLED_0603; CHIPLED_0603
IC1: STM32F102C8-B/STM32F103C8-B; TQFP48
J3: USB-4-A-SMD; USB-A-SMD
JP1: JUMPER-2SMD-NO; SJ_2S-NO
JP2: M05X2PTH; AVR_ICSP
JP5: M04PTH; 1X04
L4: BEAD 600; 0603
Q1: 8M; KX-9A
R1, R2: 1K; 0603
R3, R6, R9: 10K; 0603
R4, R5: 100K; 0603
R7, R8: 22; 0603
R16: 1K5; 0603
RED: LEDCHIPLED_0603; CHIPLED_0603
RESET#: TEST-POINT3; PAD.03X.03
SWCLK: TEST-POINT1; PAD.1X1
SWDIO: TEST-POINT1; PAD.1X1
U7: TPS73033; SOT23-5
X1: USB-SMD; USB-MINIB

Connections:
BOOT0: IC1.44 (BOOT0), JP1.2, R4.2
GND: C2.1, C4.1, C6.1, C13.1, C14.2, C15.1, C24.1, C25.1, C26.1, C29.2, GND.P$1, IC1.2 (PC13), IC1.3 (PC14), IC1.4 (PC15), IC1.8 (VSSA), IC1.10 (PA0), IC1.11 (PA1), IC1.12 (PA2), IC1.18 (PB0), IC1.19 (PB1), IC1.21 (PB10), IC1.22 (PB11), IC1.23 (VSS_1), IC1.27 (PB14), IC1.28 (PB15), IC1.35 (VSS_2), IC1.41 (PB5), IC1.42 (PB6), IC1.43 (PB7), IC1.45 (PB8), IC1.47 (VSS_3), J3.GND, JP2.3, JP2.5, JP2.7, JP2.9, JP5.2, R1.2, R2.1, R4.1, R5.1, R9.1, U7.2 (GND), X1.GND, X1.GND@1 (GND), X1.GND@2 (GND), X1.GND@3 (GND), X1.GND@4 (GND)
unnamed: R1.1, RED.C
unnamed: C25.2, C26.2, IC1.9 (VDDA), L4.1
unnamed: J3.D-, R7.1, X1.D-
unnamed: GREEN.C, R2.2
unnamed: J3.D+, R8.2, R16.1, X1.D+
OSCIN: C14.1, IC1.6 (PD1/OSC=>), Q1.1
OSCOUT: C13.2, IC1.5 (PD0/OSC<=), Q1.3 (2)
PA3-VREF: IC1.13 (PA3), R3.1, R9.2
PA4-SWDIO/TMS: IC1.14 (PA4), JP2.2
PA5-SWCLK/TCK: IC1.15 (PA5), JP2.4
PA6-SWO/TDO: IC1.16 (PA6), JP2.6
PA7-TDI: IC1.17 (PA7), JP2.8
PA8: IC1.29 (PA8), R16.2
PA9-TX: IC1.30 (PA9), JP5.4
PA10-RX: IC1.31 (PA10), JP5.3
PA11: IC1.32 (PA11), R7.2
PA12: IC1.33 (PA12), R8.1
PA13-SWDIO: IC1.34 (PA13), SWDIO.P$1
PA14-SWCLK: IC1.37 (PA14), SWCLK.P$1
PB2/BOOT1: IC1.20 (PB2), R5.2
PB9-NRESET: IC1.46 (PB9), JP2.10
PB12: GREEN.A, IC1.25 (PB12)
PB13: IC1.26 (PB13), RED.A
RESET#: C15.2, IC1.7 (NRST), R6.1, RESET#.P$1
VDD: C2.2, C4.2, C6.2, C24.2, IC1.1 (VBAT), IC1.24 (VDD_1), IC1.36 (VDD_2), IC1.48 (VDD_3), JP1.1, JP5.1, L4.2, R6.2, U7.5 (OUT)
VEE: C29.1, J3.VUSB (VBUS), U7.1 (IN), U7.3 (EN), X1.VBUS
VTREF: JP2.1, R3.2

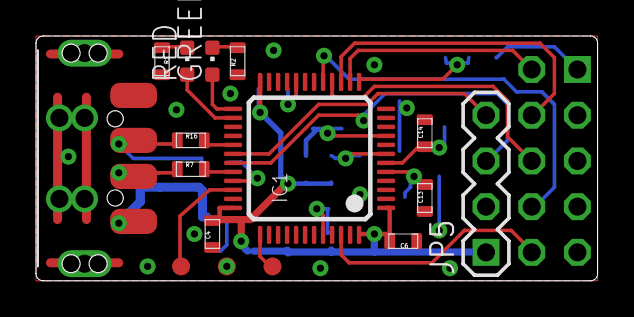
[picture p20: board CMSIS-DAP.V2.brd from above]

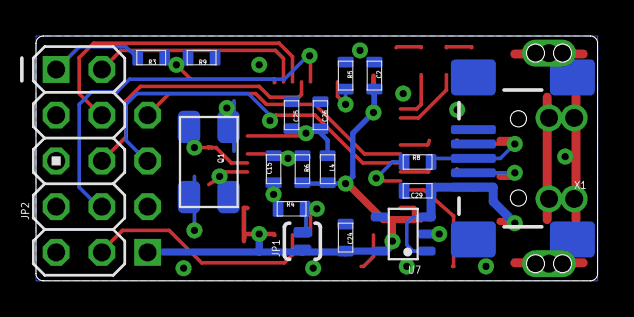
[picture p21: board CMSIS-DAP.V2.brd from below]

Board: 2 copper layers, 31.2 x 13.6 mm, 35 parts (19 on the bottom side), 29 nets.
