x893/CMSIS-DAP/(commit log)

2013-03-05 Change to composite device CDC + HID. Additional serial port for general purpose.
2013-06-05 Hardware version 2 of STM32 small debug adapter. Fixup some codes.
    [CMSIS-DAP.V1.brd, CMSIS-DAP.V1.sch, CMSIS-DAP.V2.brd, CMSIS-DAP.V2.sch]
2013-07-23 Fix RESET pin
    [CMSIS-DAP.V1.brd, CMSIS-DAP.V2.brd, CMSIS-DAP.V2.sch]
2014-11-15 Add HEX file
    [CMSIS-DAP.V2.brd, CMSIS-DAP.V2.sch]
2015-02-17 Add STM32F102CB for V2 PCB
2015-07-23 Add CMSIS-DAP for STLink V2.1 and STLink v2.1 mini adapter.
    [STLink.v21.brd, STLink.v21.sch]
2016-01-16 Add STLink.v21.pdf schematic
2016-01-17 Add JLink-OB PCB
    [JLink-OB.brd, JLink-OB.sch]
2016-11-28 Add JLink-OB-F072 hardware
    [JLink-OB-F072.brd, JLink-OB-F072.sch]
